kostoskistefan/flight-simulator-platform/docs/Flight Simulator Platform Bottom.step

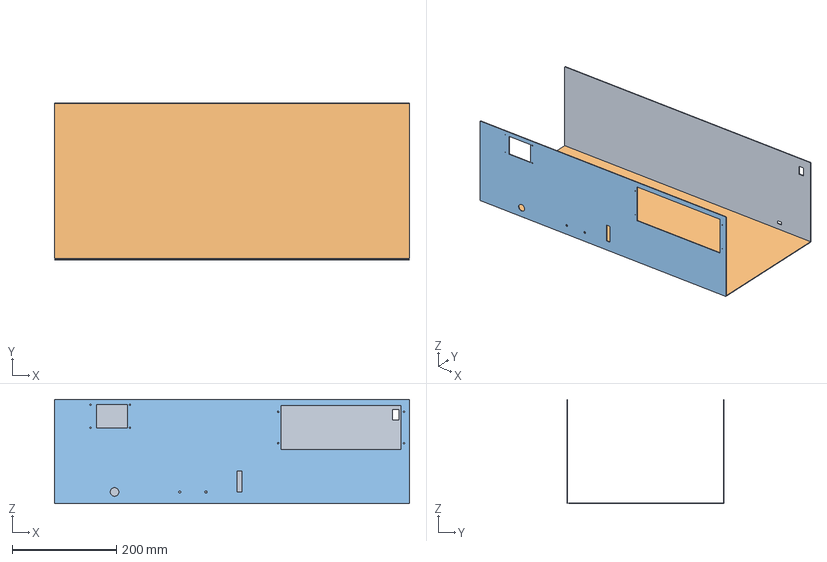
[picture p1: CAD file, 2023-11-23]
docs/Flight Simulator Platform Bottom.step
680.0 x 301.5 x 200.0 mm
Rear Panel
Base Plate
Front Panel
