kostoskistefan/flight-simulator-platform/docs/Flight Simulator Platform Top.step

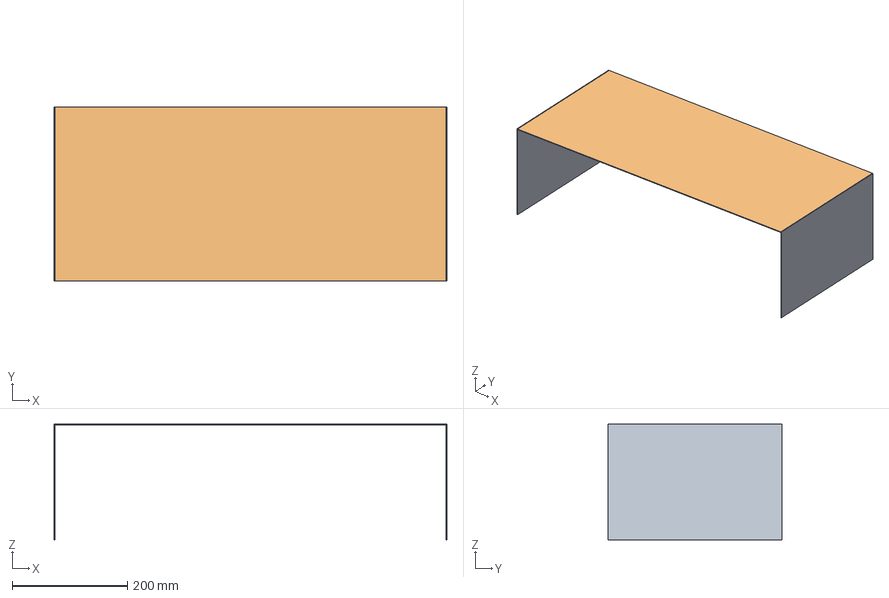
[picture p2: CAD file, 2023-11-23]
docs/Flight Simulator Platform Top.step
683.0 x 303.0 x 201.5 mm
Right Panel
Left Panel
Top Panel
