kostoskistefan/flight-simulator-platform/docs/Bendix King KX155 PCB.pdf

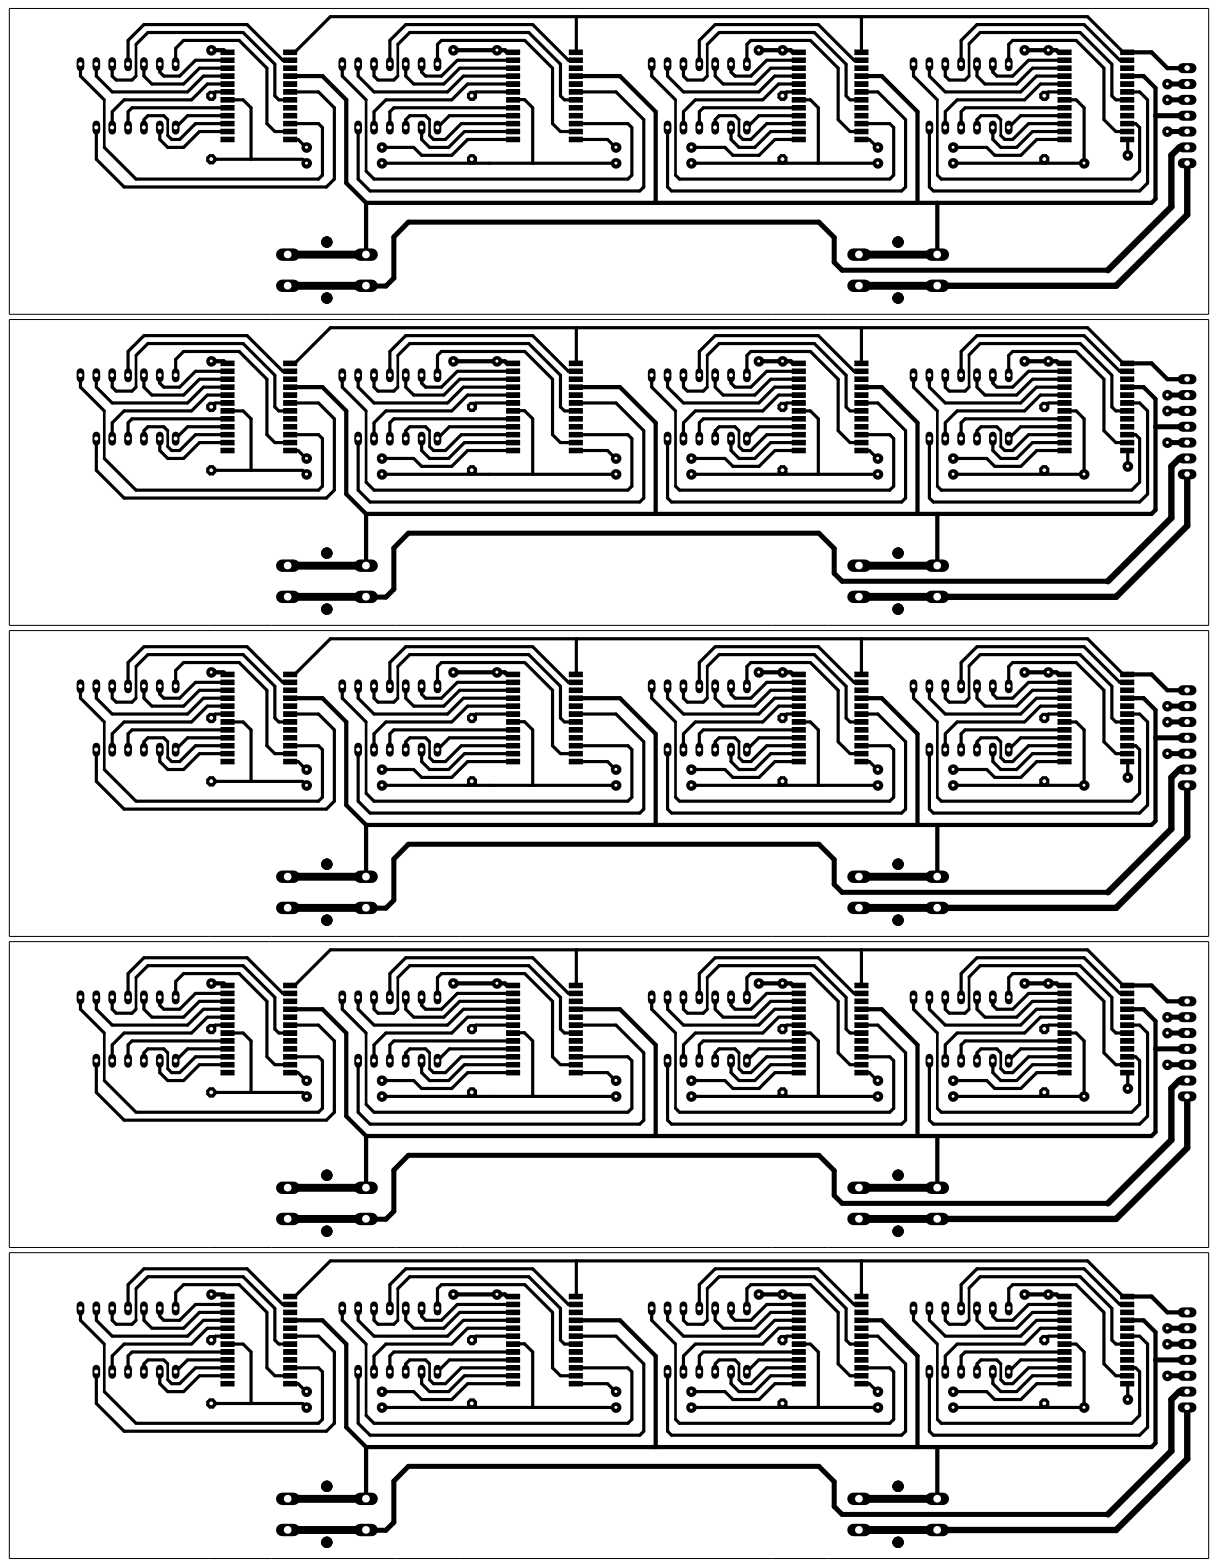
[picture p3: page 1]
