kostoskistefan/flight-simulator-platform/docs/Flight Simulator Platform Decals.pdf

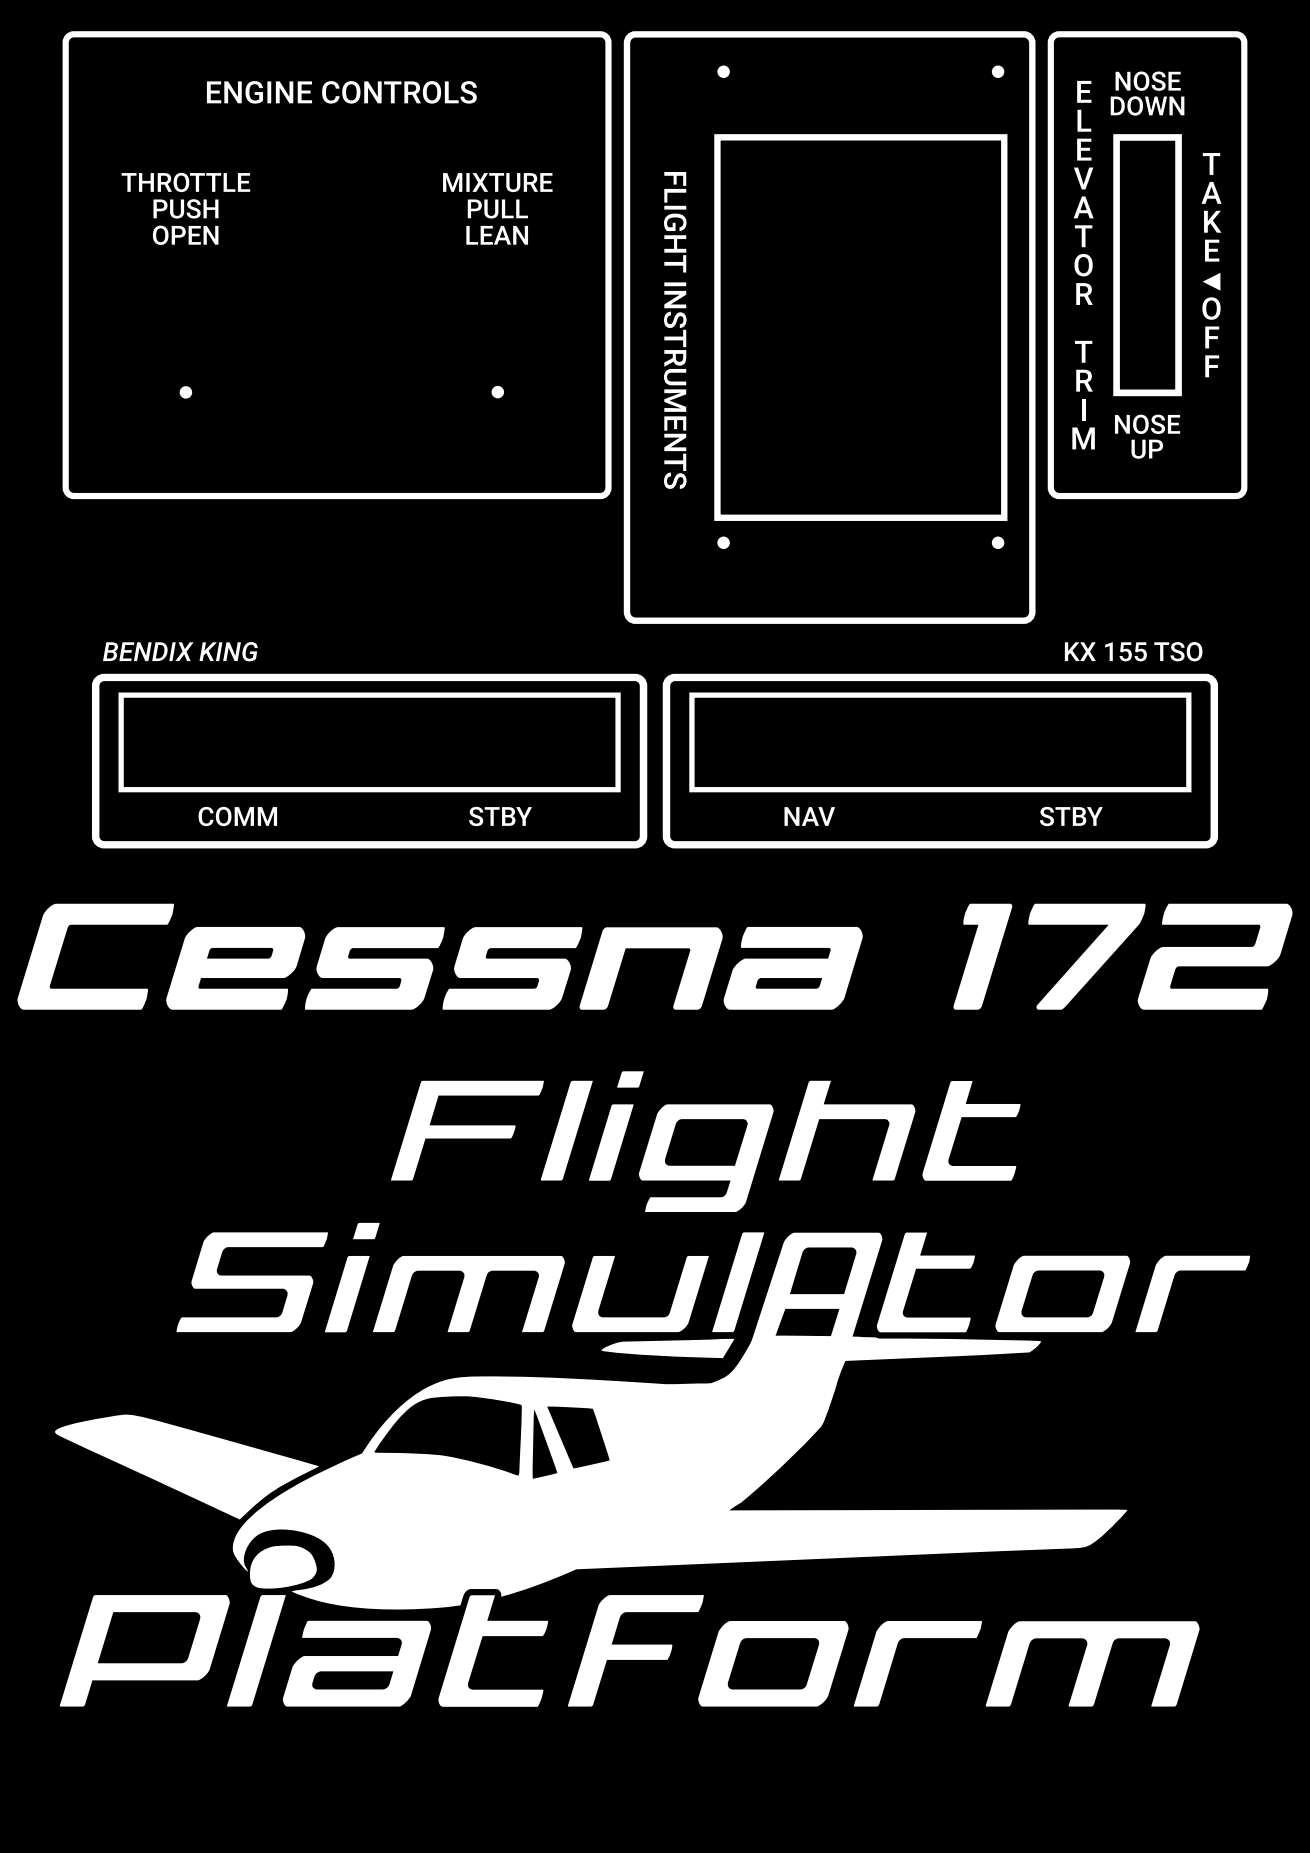
[picture p4: page 1]
