kostoskistefan/flight-simulator-platform/docs/Flight Simulator Platform Front Panel.pdf

5.5 5.5
5.5 5.5

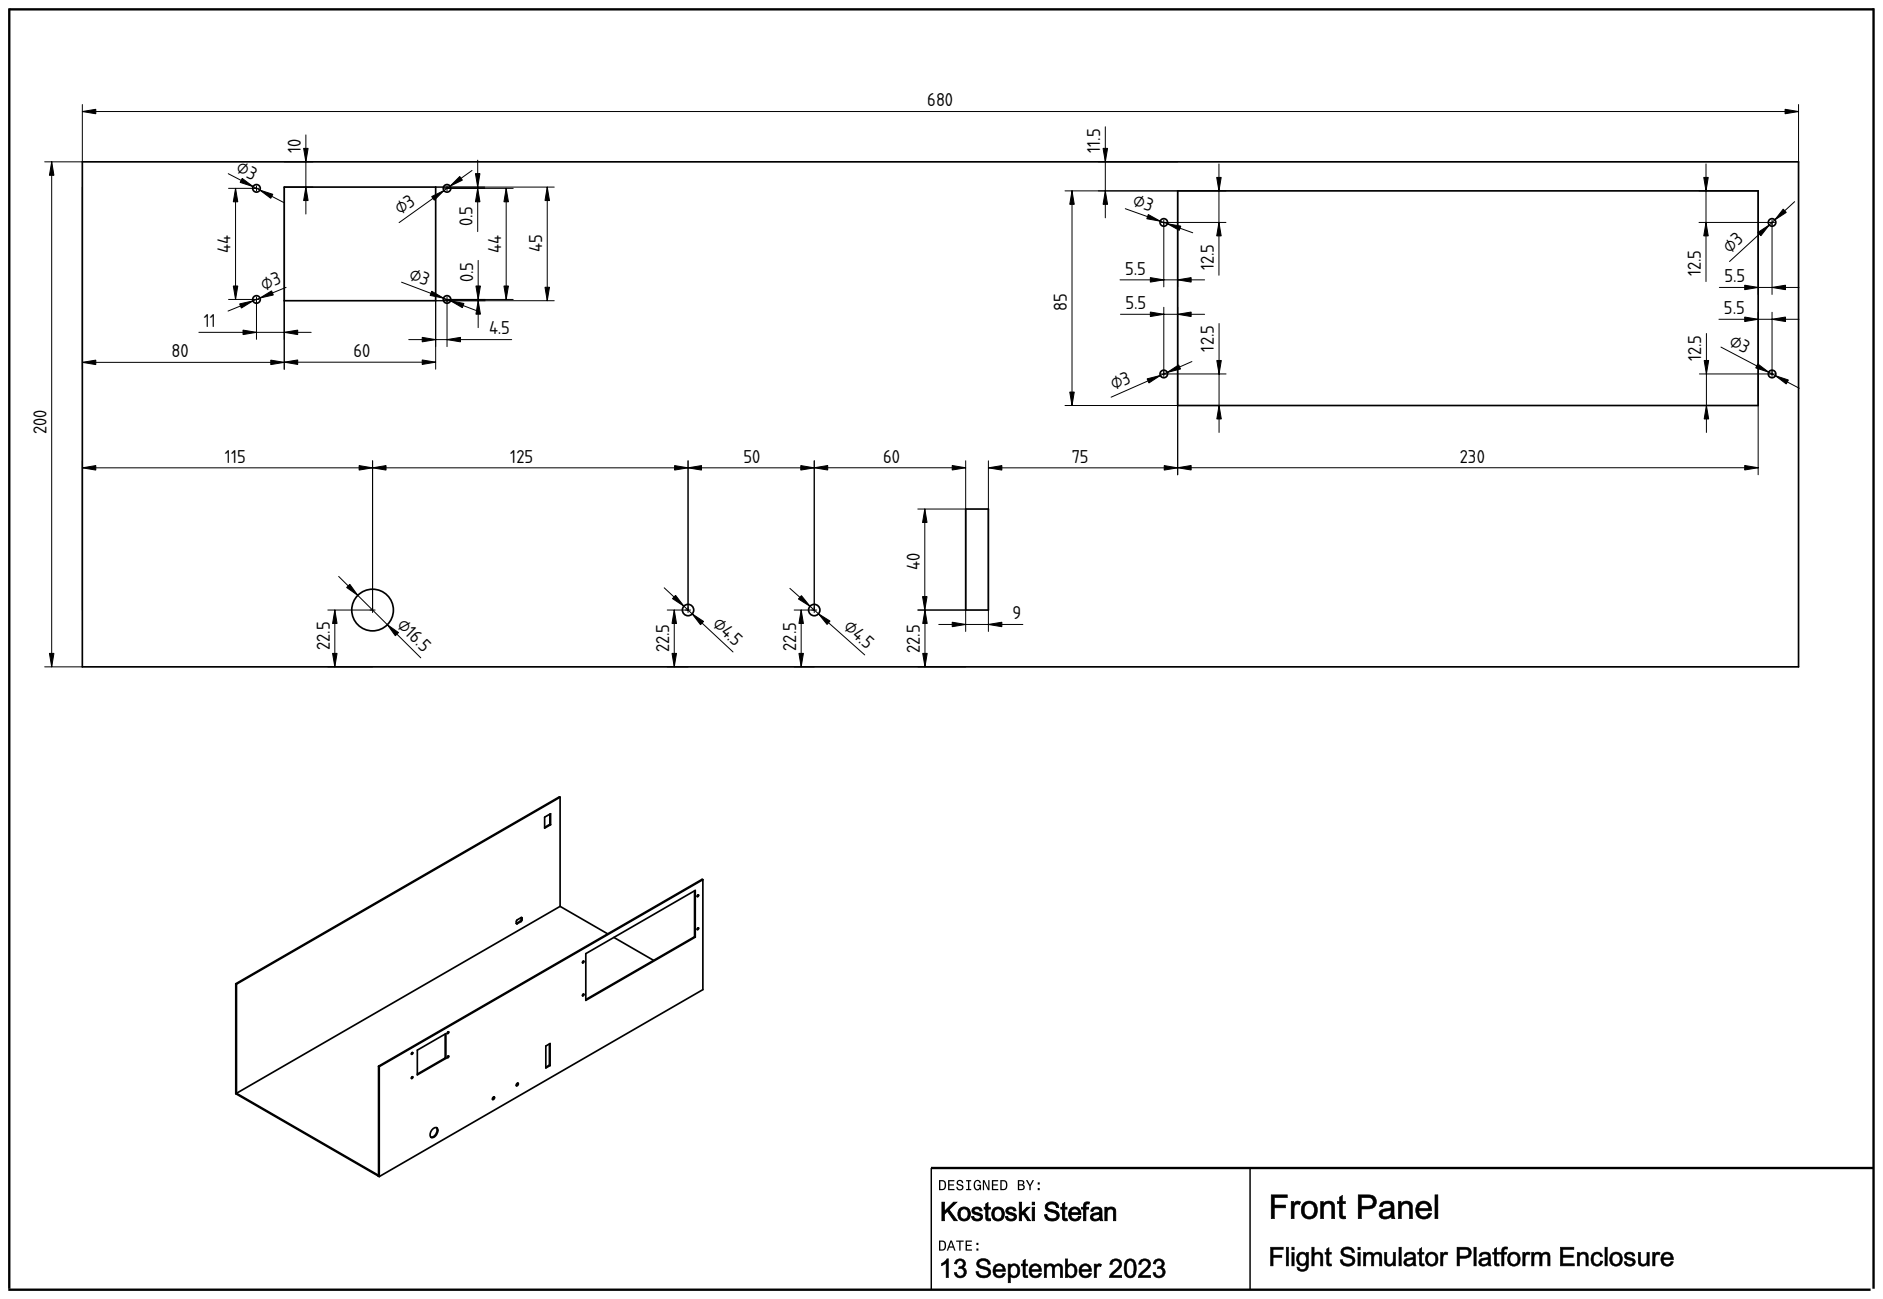
[picture p5: page 1]
