kostoskistefan/flight-simulator-platform/docs/Flight Simulator Platform Rear Panel.pdf

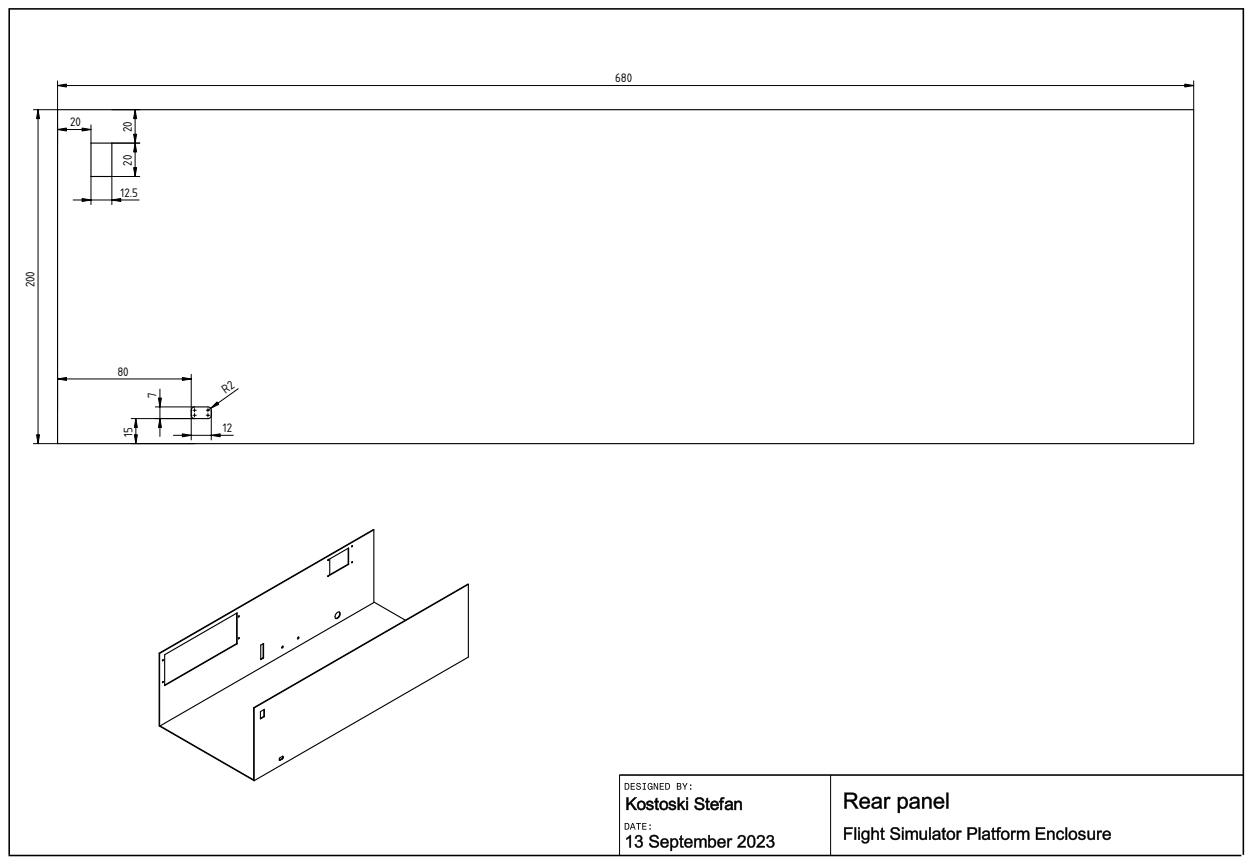
[picture p6: page 1]
