kostoskistefan/flight-simulator-platform/docs/Bendix King KX155 KiCAD/Single Display.kicad_pcb

## KiCad design docs/Bendix King KX155 KiCAD/Single Display.kicad_pcb (2023-11-23)

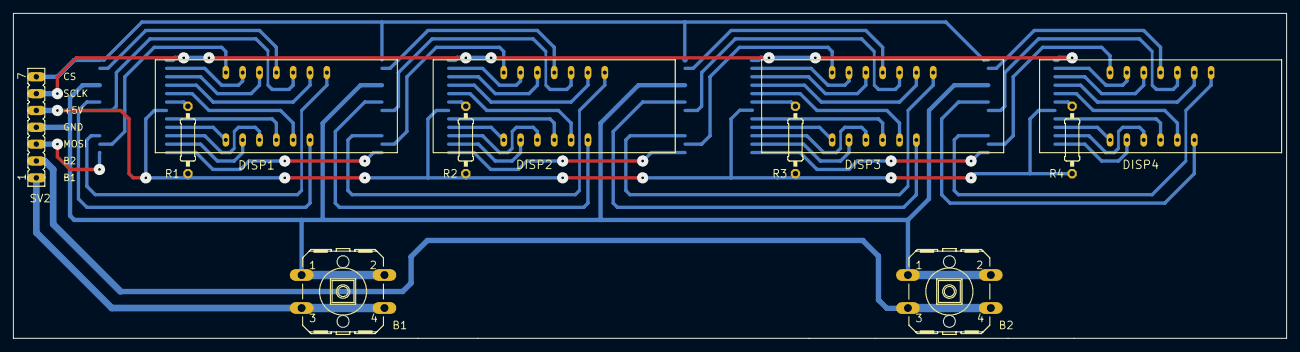
[picture p7: board Single Display.kicad_pcb from above]

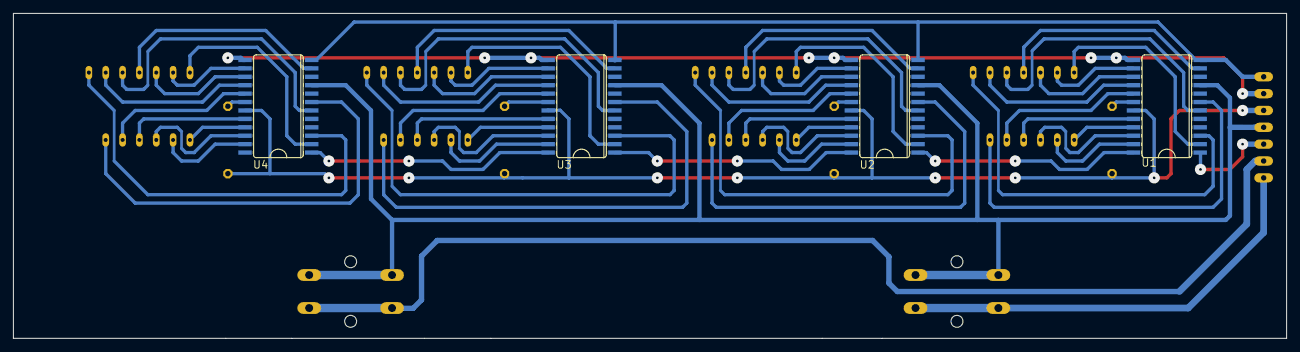
[picture p8: board Single Display.kicad_pcb from below]

Board: 2 copper layers, 192.0 x 49.0 mm, 15 parts (4 on the bottom side), 66 nets.

Parts:
B1, B2: 40-XX; B3F-40XX
DISP1, DISP2, DISP3, DISP4: 5_DIGIT_7SEGMENT_DISPLAY
R1, R2, R3, R4: R-EU_0207/10; 0207_10
SV2: FE07-1; FE07
U1, U2, U3, U4: MAX7219CWG; SO24L

Connections:
/CLK: SV2.6, U1.13 (CLK), U2.13 (CLK), U3.13 (CLK), U4.13 (CLK)
/DIN: SV2.3, U1.1 (DIN)
/LOAD: SV2.7, U1.12 (LOAD), U2.12 (LOAD), U3.12 (LOAD), U4.12 (LOAD)
/VCC: R1.1, R2.1, R3.1, R4.1, SV2.5, U1.19 (VCC), U2.19 (VCC), U3.19 (VCC), U4.19 (VCC)
GND: B1.1 (S), B1.2 (S1), B2.1 (S), B2.2 (S1), SV2.4, U1.4 (GND@1), U1.9 (GND@2), U2.4 (GND@1), U2.9 (GND@2), U3.4 (GND@1), U3.9 (GND@2), U4.4 (GND@1), U4.9 (GND@2)
unnamed: B1.3, B1.4 (P1), SV2.1
unnamed: B2.3, B2.4 (P1), SV2.2
unnamed: DISP1.DIG1, U1.2 (DIG0)
unnamed: DISP1.DIG2, U1.11 (DIG1)
unnamed: DISP1.DIG3, U1.6 (DIG2)
unnamed: DISP1.DIG4, U1.7 (DIG3)
unnamed: DISP1.DIG5, U1.3 (DIG4)
unnamed: U1.24 (DOUT), U2.1 (DIN)
unnamed: R1.2, U1.18 (ISET)
unnamed: DISP1.A, U1.14 (SEGA)
unnamed: DISP1.B, U1.16 (SEGB)
unnamed: DISP1.C, U1.20 (SEGC)
unnamed: DISP1.D, U1.23 (SEGD)
unnamed: DISP1.DP, U1.22 (SEGDP)
unnamed: DISP1.E, U1.21 (SEGE)
unnamed: DISP1.F, U1.15 (SEGF)
unnamed: DISP1.G, U1.17 (SEGG)
unnamed: DISP2.DIG1, U2.2 (DIG0)
unnamed: DISP2.DIG2, U2.11 (DIG1)
unnamed: DISP2.DIG3, U2.6 (DIG2)
unnamed: DISP2.DIG4, U2.7 (DIG3)
unnamed: DISP2.DIG5, U2.3 (DIG4)
unnamed: U2.24 (DOUT), U3.1 (DIN)
unnamed: R2.2, U2.18 (ISET)
unnamed: DISP2.A, U2.14 (SEGA)
unnamed: DISP2.B, U2.16 (SEGB)
unnamed: DISP2.C, U2.20 (SEGC)
unnamed: DISP2.D, U2.23 (SEGD)
unnamed: DISP2.DP, U2.22 (SEGDP)
unnamed: DISP2.E, U2.21 (SEGE)
unnamed: DISP2.F, U2.15 (SEGF)
unnamed: DISP2.G, U2.17 (SEGG)
unnamed: DISP3.DIG1, U3.2 (DIG0)
unnamed: DISP3.DIG2, U3.11 (DIG1)
unnamed: DISP3.DIG3, U3.6 (DIG2)
unnamed: DISP3.DIG4, U3.7 (DIG3)
unnamed: DISP3.DIG5, U3.3 (DIG4)
unnamed: U3.24 (DOUT), U4.1 (DIN)
unnamed: R3.2, U3.18 (ISET)
unnamed: DISP3.A, U3.14 (SEGA)
unnamed: DISP3.B, U3.16 (SEGB)
unnamed: DISP3.C, U3.20 (SEGC)
unnamed: DISP3.D, U3.23 (SEGD)
unnamed: DISP3.DP, U3.22 (SEGDP)
unnamed: DISP3.E, U3.21 (SEGE)
unnamed: DISP3.F, U3.15 (SEGF)
unnamed: DISP3.G, U3.17 (SEGG)
unnamed: DISP4.DIG1, U4.2 (DIG0)
unnamed: DISP4.DIG2, U4.11 (DIG1)
unnamed: DISP4.DIG3, U4.6 (DIG2)
unnamed: DISP4.DIG4, U4.7 (DIG3)
unnamed: DISP4.DIG5, U4.3 (DIG4)
unnamed: R4.2, U4.18 (ISET)
unnamed: DISP4.A, U4.14 (SEGA)
unnamed: DISP4.B, U4.16 (SEGB)
unnamed: DISP4.C, U4.20 (SEGC)
unnamed: DISP4.D, U4.23 (SEGD)
unnamed: DISP4.DP, U4.22 (SEGDP)
unnamed: DISP4.E, U4.21 (SEGE)
unnamed: DISP4.F, U4.15 (SEGF)
unnamed: DISP4.G, U4.17 (SEGG)
