kostoskistefan/flight-simulator-platform/src/main.cc

#include "x_plane_controller.h"

x_plane_controller_s x_plane_controller;

void setup(void)
{
    x_plane_controller_initialize(&x_plane_controller);
}

void loop(void)
{
    x_plane_controller_run(&x_plane_controller);
}
