kostoskistefan/flight-simulator-platform/include/com_nav_radio.h

#ifndef COM_NAV_RADIO_H
#define COM_NAV_RADIO_H

#include "button.h"
#include "encoder.h"
#include "LedControl_HW_SPI.h"
#include "x_plane_interface.h"

typedef struct com_nav_radio_s
{
    uint8_t com_right_is_selected;
    uint8_t nav_right_is_selected;

    button_s button_com_frequency_transfer;
    button_s button_nav_frequency_transfer;

    encoder_s encoder_com_mhz;
    encoder_s encoder_com_khz;
    encoder_s encoder_nav_mhz;
    encoder_s encoder_nav_khz;

    LedControl_HW_SPI display;
} com_nav_radio_s;

void com_nav_radio_initialize(com_nav_radio_s *com_nav_radio);
void com_nav_radio_run(com_nav_radio_s *com_nav_radio, rref_reply_packet_s *received_packets);

#endif // COM_NAV_RADIO_H
