kostoskistefan/flight-simulator-platform/include/definitions.h

#ifndef DEFINITIONS_H
#define DEFINITIONS_H

#define X_PLANE_PORT          49000
#define X_PLANE_GATEWAY       { 192, 168, 12, 1 }
#define X_PLANE_COMPUTER_IP   { 192, 168, 12, 1 }
#define X_PLANE_CONTROLLER_IP { 192, 168, 12, 100 }

#define WIFI_SSID     "XPlaneNetwork"
#define WIFI_PASSWORD "xplane11net"

#define UPDATE_SEND_PERIOD 80

#define BUTTON_DEBOUNCE_TIME 30

#define MAXIMUM_PACKETS_TO_RECEIVE 15

#endif // DEFINITIONS_H
