kostoskistefan/flight-simulator-platform/src/value_remapper.cc

#include "value_remapper.h"

float value_remapper_remap(float x, float in_min, float in_max, float out_min, float out_max)
{
    return (x - in_min) * (out_max - out_min) / (in_max - in_min) + out_min;
};
