kostoskistefan/flight-simulator-platform/(commit log)

2023-08-20 Add tft and analog sensors
2023-08-21 Add encoders and radio
2023-09-05 Fixed x_plane_interface to read multiple values
    [button.cc, com_nav_radio.cc, com_nav_radio.h, definitions.h, elevator_trim.cc, encoder.cc, encoder.h, flight_instruments.cc]
2023-09-07 Fix calibration
2023-10-04 Remap pins to use HW SPI
2023-10-06 Change pins to accommodate updated pcb
2023-11-23 Add hardware design files
    [Flight Simulator Platform Bottom.step, Flight Simulator Platform Top.step, Single Display.kicad_pcb, Single Display.kicad_sch]
